Ocanath/robot-cortex-pcb/DCC6C.STEP

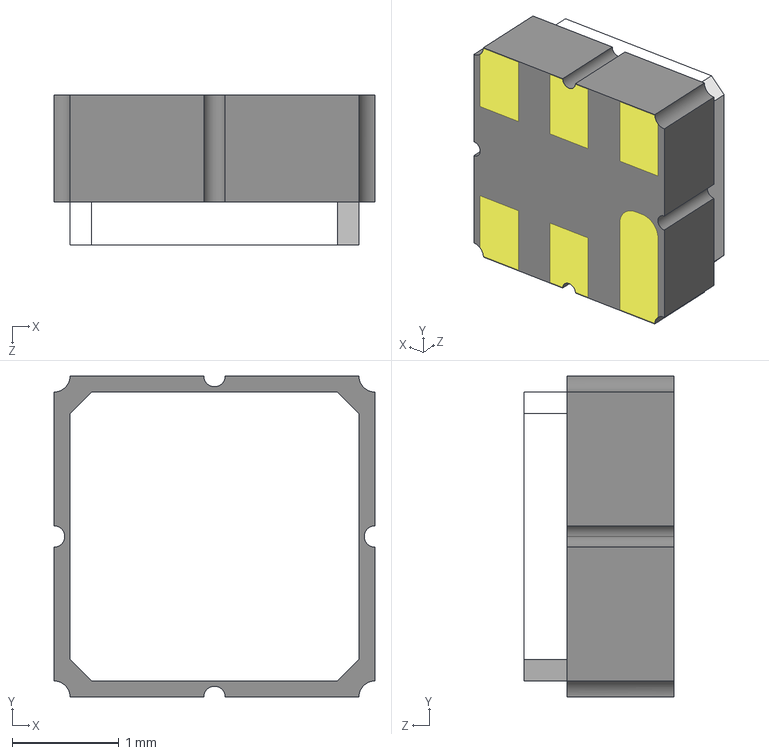
[picture p1: CAD file, 2021-05-17]
DCC6C.STEP
3.00 x 3.00 x 1.40 mm
