Ocanath/robot-cortex-pcb/sma-conn.stp

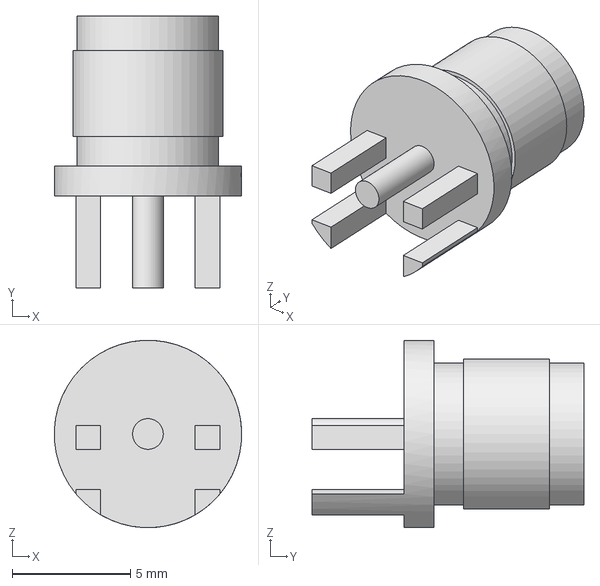
[picture p2: CAD file, 2019-07-01]
sma-conn.stp
7.93 x 11.5 x 7.93 mm
