Ocanath/robot-cortex-pcb/483930003.stp

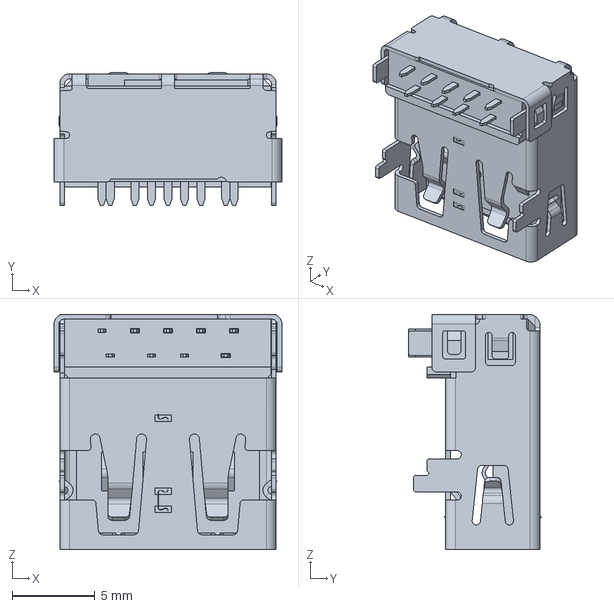
[picture p3: CAD file, 2020-09-10]
483930003.stp
13.8 x 8.04 x 14.3 mm
