Ocanath/robot-cortex-pcb/(list of files, cad)

Other CAD files:
AFS2442.0S4.SLDPRT
sma-conn.ipt
