Ocanath/robot-cortex-pcb/(list of files, drawings)

Other design files:
CC1101-CC1190.SchDoc
connectors.SchDoc
cp2102.SchDoc
mpu6500.SchDoc
nrf24l01.SchDoc
nrf52-coprocessor.SchDoc
pcb.PcbDoc
power-management.SchDoc
ReferenceDesign/CC1101_CC1190EM_915MHz_1_2_0.pcb
RLC.PcbLib
RLC.SchLib
robot-cortex.PcbLib
robot-cortex.PrjPCB
robot-cortex.SchLib
uC.SchDoc
