Ocanath/robot-cortex-pcb/(commit log)

2019-06-05 init commit, some good progress on layout and uC schematic. lots of features still needed
    [connectors.SchDoc, cp2102.SchDoc, nrf24l01.SchDoc, pcb.PcbDoc, power-management.SchDoc, robot-cortex.PcbLib, robot-cortex.PrjPCB, robot-cortex.SchLib]
2019-06-05 added nrf to schematic
    [cp2102.SchDoc, nrf24l01.SchDoc, pcb.PcbDoc, power-management.SchDoc, robot-cortex.PcbLib, robot-cortex.PrjPCB, robot-cortex.SchLib]
2019-06-10 worked on design of power delivery circuitry. not sure how to do connector layout
    [nrf24l01.SchDoc, pcb.PcbDoc, power-management.SchDoc, robot-cortex.PcbLib, robot-cortex.SchLib]
2019-06-10 added charging and cp2102 to sch
    [cp2102.SchDoc, power-management.SchDoc, robot-cortex.PcbLib, robot-cortex.SchLib]
2019-06-10 added footprints to pcb for usb-com and charging
    [pcb.PcbDoc, power-management.SchDoc, robot-cortex.SchLib]
2019-06-17 layout progress, ish. haven't placed IMU yet. Might just straight up migrate to the 64 pin lqfp format for this board...
    [pcb.PcbDoc, power-management.SchDoc, robot-cortex.SchLib, uC.SchDoc]
2019-06-24 notes and layout progress
    [mpu6500.SchDoc, pcb.PcbDoc, power-management.SchDoc, robot-cortex.PcbLib, robot-cortex.PrjPCB, robot-cortex.SchLib]
2019-06-25 removed power management, will now live on a separate set of pcbs
    [pcb.PcbDoc, power-management.SchDoc]
2019-06-27 major layout progress
    [pcb.PcbDoc, power-management.SchDoc]
2019-06-27 first pass routing complete. need to review features and add NRF antenna, then i'll redo the whole thing again with the 64pin QFN package
    [pcb.PcbDoc, robot-cortex.PrjPCB]
2019-06-30 functional and dissatisfying robot master layout. I will try and improve on this design with the 64pin qfn version
    [nrf24l01.SchDoc, pcb.PcbDoc, robot-cortex.PcbLib, robot-cortex.SchLib, uC.SchDoc]
2019-06-30 marginally improved layout. more streamlined
    [pcb.PcbDoc, uC.SchDoc]
2019-06-30 moved in-pad thru hole
    [pcb.PcbDoc]
2019-06-30 added logo
    [pcb.PcbDoc]
2019-07-01 layout progess, updated uC in schematic
    [pcb.PcbDoc, power-management.SchDoc, robot-cortex.PcbLib, robot-cortex.PrjPCB, robot-cortex.SchLib, sma-conn.ipt, sma-conn.stp, uC.SchDoc]
2019-07-01 layout basically done, changed pinouts. need to review features one more time
    [nrf24l01.SchDoc, pcb.PcbDoc, uC.SchDoc]
2019-07-01 upgraded to stat version of the charging chip. added schematic annotations. tweaked locations of the gpio pins.
    [pcb.PcbDoc, power-management.SchDoc, robot-cortex.PrjPCB, robot-cortex.SchLib]
2019-07-01 route done. considering making it smaller, but i may hold off in the interest of rf isolation and time...
    [pcb.PcbDoc]
2019-07-01 poly poured. still unsure whether i will condense
    [pcb.PcbDoc]
2019-07-02 moved pull up resistor away from pads
    [pcb.PcbDoc]
2019-07-02 condensed layout somewhat
    [pcb.PcbDoc]
2019-07-02 cortex rev complete. ready to order
    [pcb.PcbDoc]
2019-07-06 gerber generated, board ordered
    [pcb.GBL, pcb.GBO, pcb.GBP, pcb.GBS, pcb.GKO, pcb.GM1, pcb.GTL, pcb.GTO]
2020-09-03 progress on new version to merge
    [pcb.GBL, pcb.GBO, pcb.GBP, pcb.GBS, pcb.GKO, pcb.GM1, pcb.GTL, pcb.GTO]
2020-09-08 notes, added transciever, no significant layout changes
    [cp2102.SchDoc, pcb.PcbDoc, robot-cortex.PcbLib, robot-cortex.SchLib, uC.SchDoc]
2020-09-09 added load disconnect when usb is plugged in. need to figure out how to switch power to usb...
    [cp2102.SchDoc, pcb.PcbDoc, power-management.SchDoc, robot-cortex.PcbLib, robot-cortex.SchLib, uC.SchDoc]
2020-09-10 power management stage complete
    [pcb.PcbDoc, power-management.SchDoc, robot-cortex.PcbLib, robot-cortex.SchLib, uC.SchDoc]
2020-09-10 updated todo
    [power-management.SchDoc]
2020-09-10 added usb 3.0 A receptacle to lib.
    [483930003.stp, robot-cortex.PcbLib, robot-cortex.SchLib]
2020-09-10 layout changes and new usb connector. color updates to net. fixed schematic design mistake (critical)
    [cp2102.SchDoc, pcb.PcbDoc, power-management.SchDoc, robot-cortex.PcbLib, robot-cortex.PrjPCB, robot-cortex.SchLib, uC.SchDoc]
2020-09-11 oruting projgnress im druuunk so i need for not break everythgins
    [pcb.PcbDoc]
2020-09-11 drunk jesse updated sch and pcb lib and added pmosese for the power managment
    [pcb.PcbDoc, power-management.SchDoc, robot-cortex.PcbLib, robot-cortex.PrjPCB, robot-cortex.SchLib]
2020-09-15 added flip flop for power switch toggle management. need rc lowpass for debouncing. power management layout needs to be modified to accommodate the new circuitry
    [pcb.PcbDoc, power-management.SchDoc, robot-cortex.PcbLib, robot-cortex.SchLib, uC.SchDoc]
2020-09-15 added switch
    [power-management.SchDoc, robot-cortex.PcbLib, robot-cortex.SchLib, uC.SchDoc]
2020-09-16 added a pullup resistor. idk if this will work. should proably add jumpers to bypass my experimental circuitry
    [power-management.SchDoc]
2020-09-20 design finalized
    [power-management.SchDoc, robot-cortex.SchLib, uC.SchDoc]
2020-09-21 almost there
    [cp2102.SchDoc, power-management.SchDoc, robot-cortex.PcbLib, robot-cortex.SchLib, uC.SchDoc]
2020-09-22 silk cleanup and attempt at proj variants...
    [power-management.SchDoc, robot-cortex.PcbLib, robot-cortex.PrjPCB]
2020-09-22 variant success
    [power-management.SchDoc, robot-cortex.PrjPCB]
2020-09-23 added silk marking for usb. needs bom management
2020-09-27 placed assembly jlc. enormous amoutn of money in this order. feeling nervous
    [BOM-robot-cortex.csv, PNP-robot-cortex.csv, cp2102.SchDoc, mpu6500.SchDoc, nrf24l01.SchDoc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]
2020-09-27 order submitted and paid
    [pcb.GBL, pcb.GBO, pcb.GBP, pcb.GBS, pcb.GKO, pcb.GM1, pcb.GTL, pcb.GTO]
2021-03-15 init commit v2, added schdoc and uc oscillator
    [CC1101-CC1190.SchDoc, robot-cortex.PrjPCB, robot-cortex.SchLib, uC.SchDoc]
2021-03-18 cc1190 and cc1101 schlib
    [robot-cortex.PrjPCB, robot-cortex.SchLib]
2021-03-23 swapped op amp for schmitt trigger
    [CC1101-CC1190.SchDoc, nrf24l01.SchDoc, power-management.SchDoc, robot-cortex.PcbLib, robot-cortex.PrjPCB, robot-cortex.SchLib, uC.SchDoc]
2021-03-25 added new generic rlc component lib, which i'll probably start transferring to others as a gen purpose intlib or similar. partial progress on the radio layout
    [CC1101-CC1190.SchDoc, CC1101-CC1190EM_915MHz_PARTLIST_1_2_0.xls, CC1101_CC1190EM_915MHz_1_2_0.pcb, RLC.PcbLib, RLC.SchLib, cp2102.SchDoc, mpu6500.SchDoc, nrf24l01.SchDoc]
2021-05-17 sch form is mostl done. needs oscillator, validation, component values, antenna, SPI+UART mapping to uC
    [AFS2442.0S4.SLDPRT, AFS2442.0S4.STEP, CC1101-CC1190.SchDoc, DCC6C.STEP, robot-cortex.PcbLib, robot-cortex.SchLib]
2021-05-24 many updates, including compoment values for CC chips, addition of mpu co-processor
    [CC1101-CC1190.SchDoc, RLC.PcbLib, RLC.SchLib, mpu6500.SchDoc, nrf24l01.SchDoc, nrf52-coprocessor.SchDoc, robot-cortex.PcbLib, robot-cortex.PrjPCB]
2021-07-08 i think design ready to route
    [CC1101-CC1190.SchDoc, robot-cortex.PcbLib, robot-cortex.SchLib]
2021-07-08 added power distrib with parallel pmos. because why not.
    [CC1101-CC1190.SchDoc, power-management.SchDoc, robot-cortex.PcbLib, robot-cortex.PrjPCB, robot-cortex.SchLib, uC.SchDoc]
2021-08-03 routing of radiogit status clean and fairly consistent with example layout
    [CC1101-CC1190.SchDoc]
2021-08-04 major routing progress and modification of nrf52 spi pins
    [nrf52-coprocessor.SchDoc]
2021-08-04 prog headers
    [RLC.PcbLib, RLC.SchLib, power-management.SchDoc, robot-cortex.PcbLib, robot-cortex.SchLib]
2021-08-04 shifted around pads for hp distrib board
    [nrf52-coprocessor.SchDoc, power-management.SchDoc, robot-cortex.PrjPCB, uC.SchDoc]
2021-08-04 connector and silk updates
    [nrf52-coprocessor.SchDoc, robot-cortex.PcbLib, robot-cortex.SchLib, uC.SchDoc]
2021-08-04 major layout change for rf no-interfere
    [nrf52-coprocessor.SchDoc]
2021-08-14 poly update and fencing for rf circuits
